gilbertocarcano/Progetto-ACME/Docs/Presentazione/Presentazione-ACME-Redesign.pdf

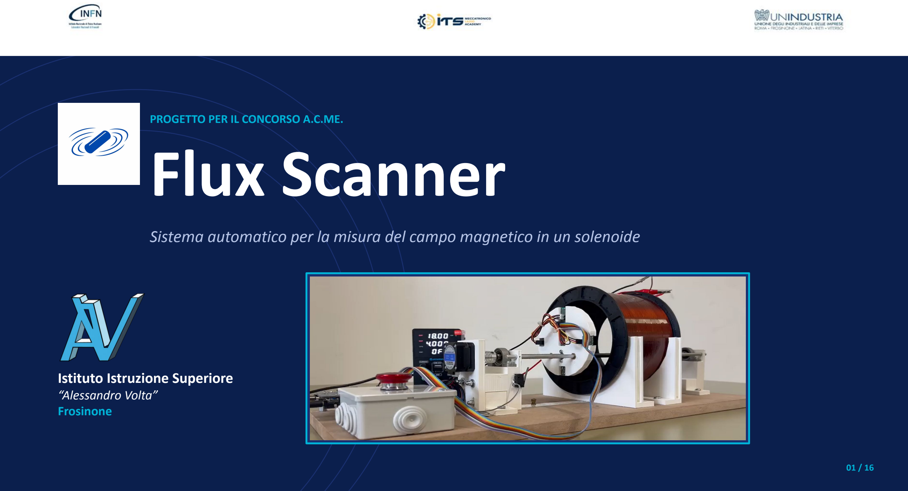
[picture p1: figure]
PROGETTO PER IL CONCORSO A.C.ME. Flux Scanner; Istituto Istruzione Superiore “Alessandro Volta” Frosinone

## Sistema automatico per la misura del campo magnetico in un solenoide

# Il problema fisico

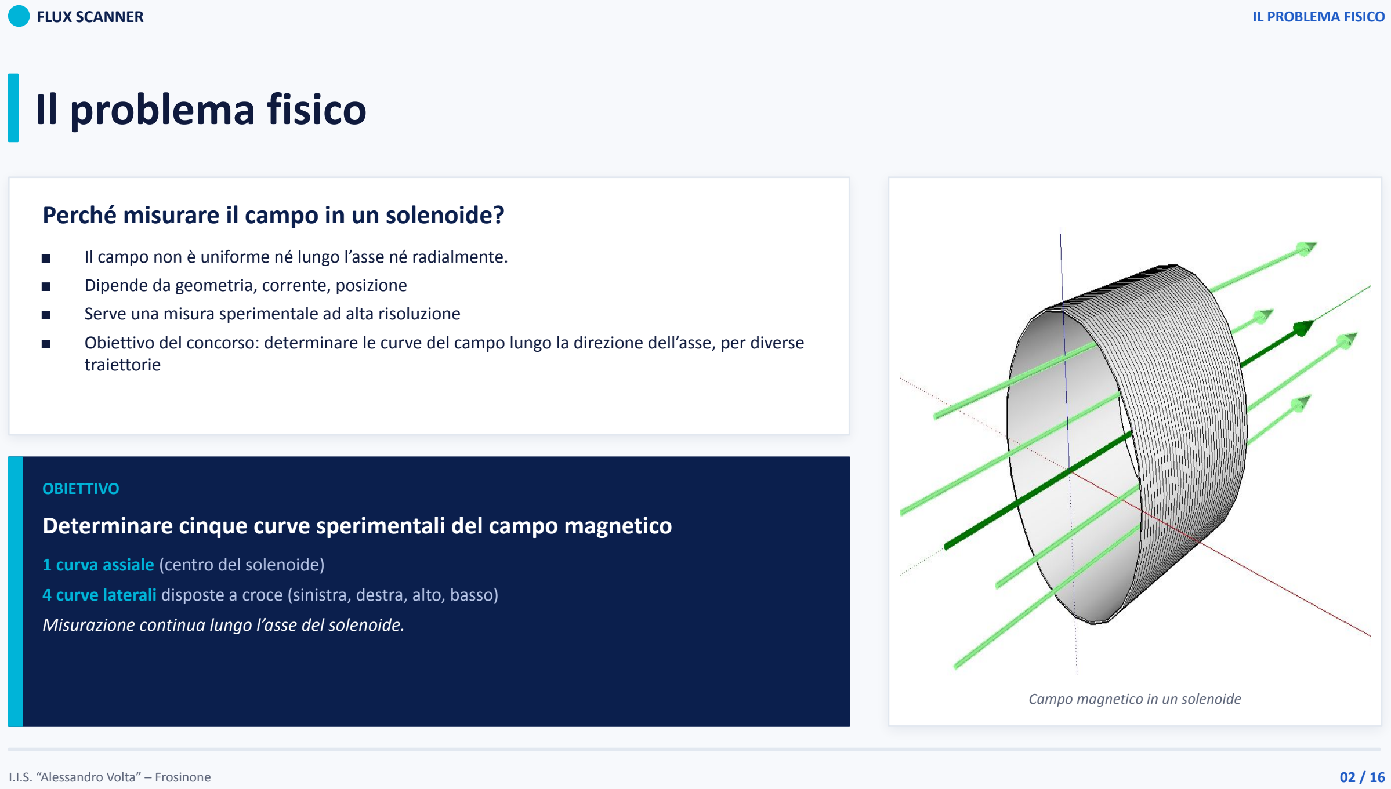
[picture p2: page 2]

FLUX SCANNER | IL PROBLEMA FISICO
I.I.S. “Alessandro Volta” – Frosinone | 02 / 16

## Perché misurare il campo in un solenoide?

■ | Il campo non è uniforme né lungo l’asse né radialmente.
■ | Dipende da geometria, corrente, posizione
■ | Serve una misura sperimentale ad alta risoluzione
■ | Obiettivo del concorso: determinare le curve del campo lungo la direzione dell’asse, per diverse traiettorie

OBIETTIVO

## Determinare cinque curve sperimentali del campo magnetico

### 1 curva assiale (centro del solenoide)

### 4 curve laterali disposte a croce (sinistra, destra, alto, basso)

Misurazione continua lungo l’asse del solenoide.

Campo magnetico in un solenoide

# Obiettivo del progetto

## Realizzare un sistema automatico in grado di:

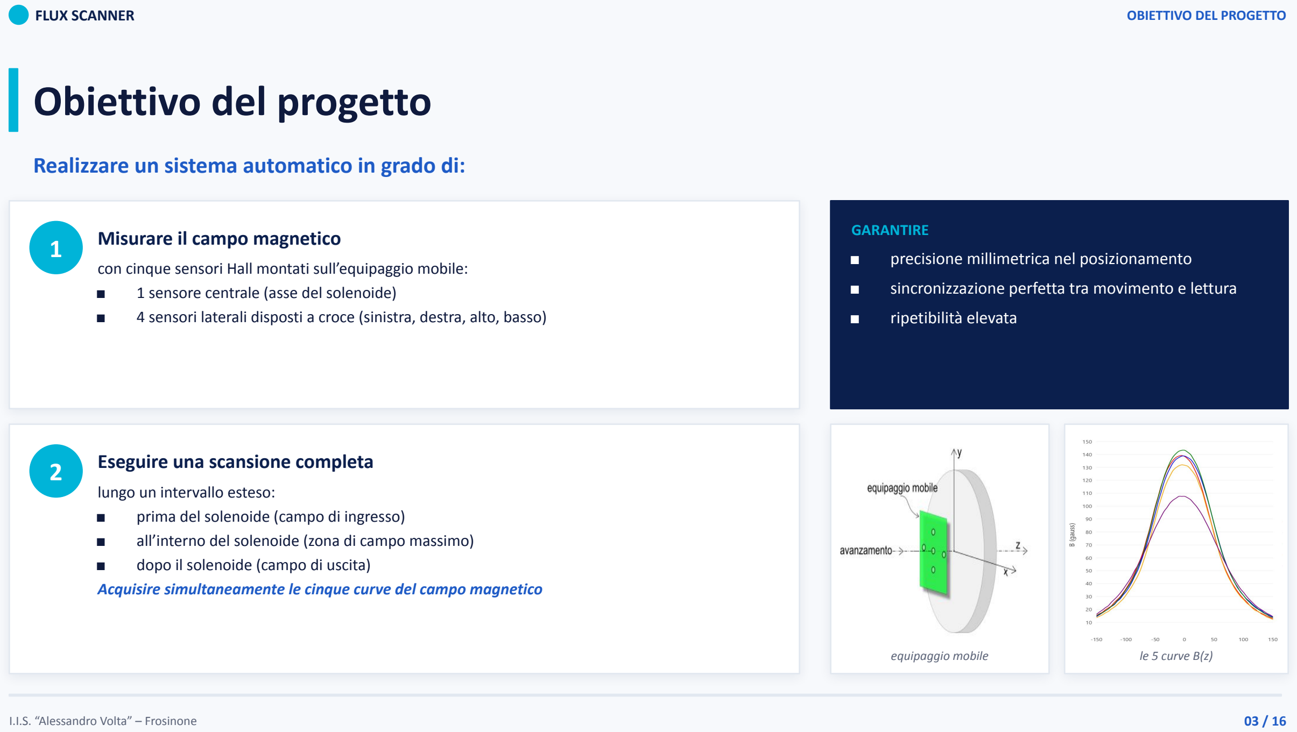
[picture p3: page 3]

FLUX SCANNER | OBIETTIVO DEL PROGETTO

1

### Misurare il campo magnetico

con cinque sensori Hall montati sull’equipaggio mobile:
■ | 1 sensore centrale (asse del solenoide)
■ | 4 sensori laterali disposti a croce (sinistra, destra, alto, basso)

2

### Eseguire una scansione completa

lungo un intervallo esteso:
■ | prima del solenoide (campo di ingresso)
■ | all’interno del solenoide (zona di campo massimo)
■ | dopo il solenoide (campo di uscita)
Acquisire simultaneamente le cinque curve del campo magnetico

GARANTIRE
■ | precisione millimetrica nel posizionamento
■ | sincronizzazione perfetta tra movimento e lettura
■ | ripetibilità elevata
equipaggio mobile | le 5 curve B(z)

# Architettura generale del sistema

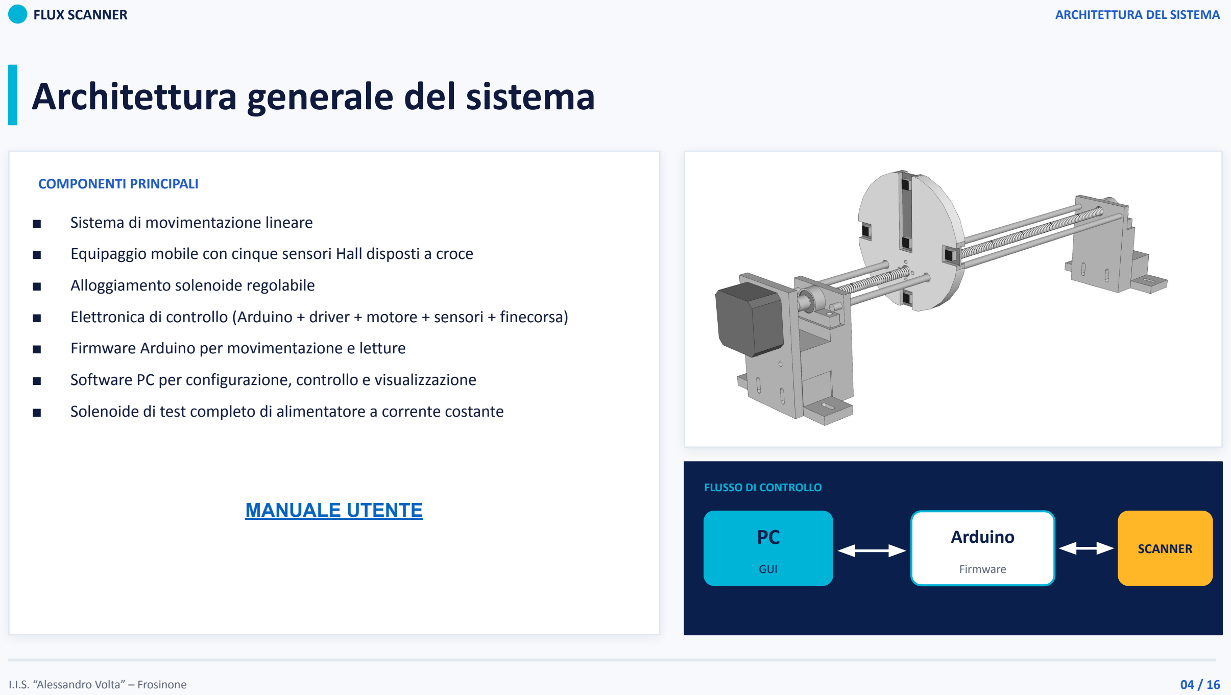
[picture p4: page 4]

FLUX SCANNER | ARCHITETTURA DEL SISTEMA

COMPONENTI PRINCIPALI

■ | Sistema di movimentazione lineare
■ | Equipaggio mobile con cinque sensori Hall disposti a croce
■ | Alloggiamento solenoide regolabile
■ | Elettronica di controllo (Arduino + driver + motore + sensori + finecorsa)
■ | Firmware Arduino per movimentazione e letture
■ | Software PC per configurazione, controllo e visualizzazione
■ | Solenoide di test completo di alimentatore a corrente costante

PC

GUI

### Arduino

Firmware

SCANNER

FLUSSO DI CONTROLLO
MANUALE UTENTE (https://drive.google.com/file/d/1rOk_jEiZlnx1uidPcFdmK0FjRhwg7ija/view?usp=drive_link)

# Scelte meccaniche: movimentazione

## Movimentazione lineare ad alta precisione

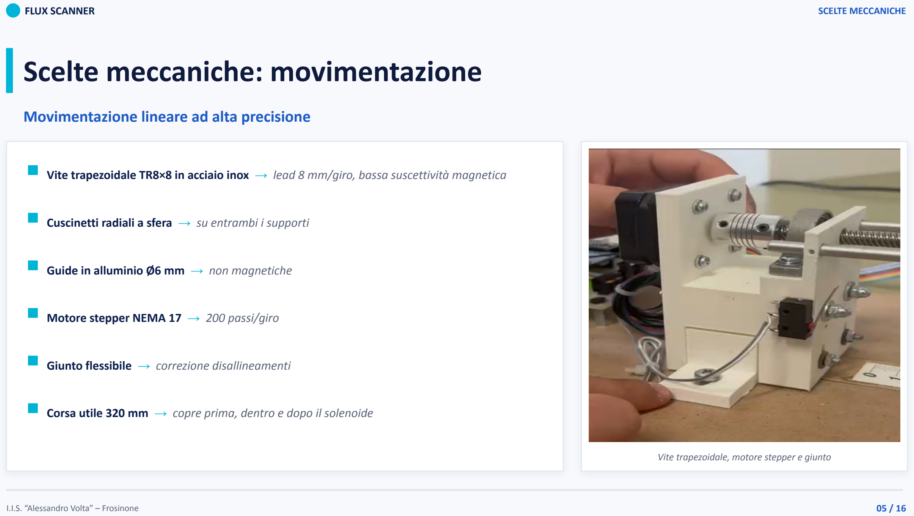
[picture p5: page 5]

FLUX SCANNER | SCELTE MECCANICHE

Vite trapezoidale TR8×8 in acciaio inox → lead 8 mm/giro, bassa suscettività magnetica

Cuscinetti radiali a sfera → su entrambi i supporti

Guide in alluminio Ø6 mm → non magnetiche

Motore stepper NEMA 17 → 200 passi/giro

Giunto flessibile → correzione disallineamenti

Corsa utile 320 mm → copre prima, dentro e dopo il solenoide

Vite trapezoidale, motore stepper e giunto

# Scelte meccaniche: equipaggio mobile

## Equipaggio mobile con 5 sensori

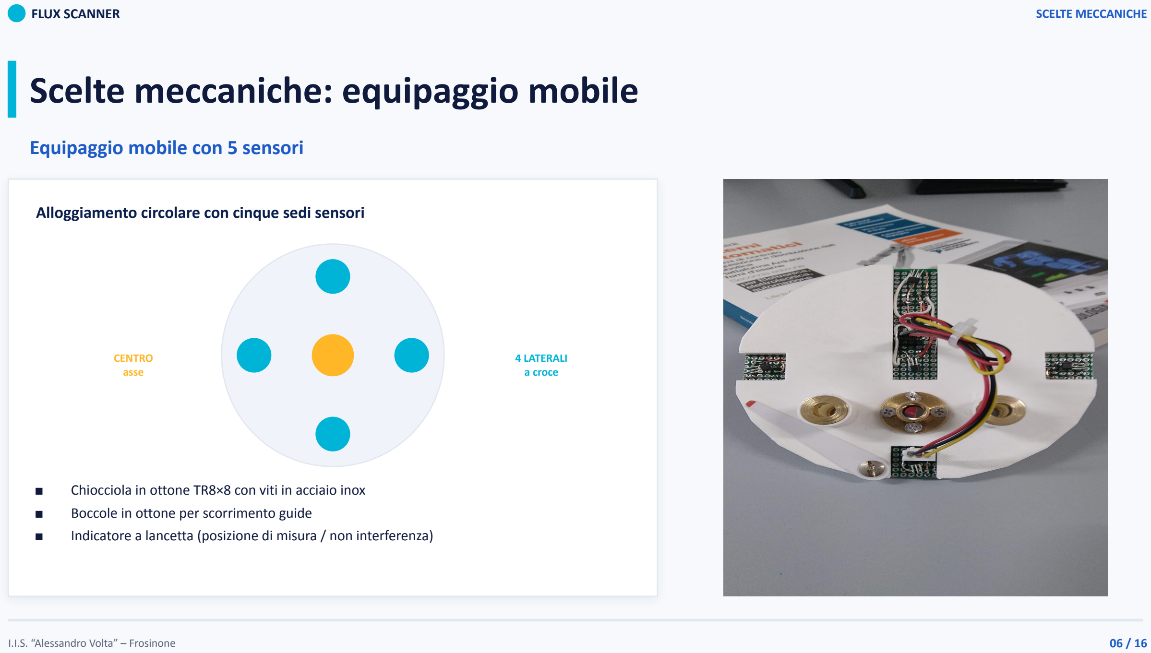
[picture p6: page 6]

FLUX SCANNER | SCELTE MECCANICHE

Alloggiamento circolare con cinque sedi sensori

CENTRO
asse

### 4 LATERALI

a croce

■ | Chiocciola in ottone TR8×8 con viti in acciaio inox
■ | Boccole in ottone per scorrimento guide
■ | Indicatore a lancetta (posizione di misura / non interferenza)

Carrello con disposizione “a croce” dei sensori

# Alloggiamento solenoide e calibrazione

## Allineamento e ripetibilità

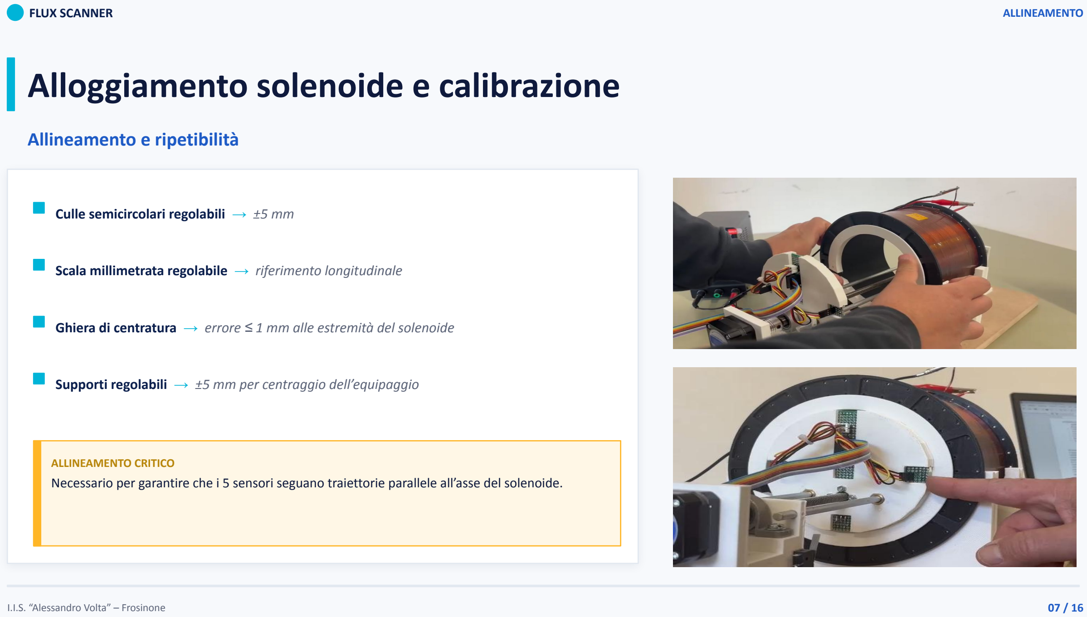
[picture p7: page 7]

FLUX SCANNER | ALLINEAMENTO

Culle semicircolari regolabili → ±5 mm

Scala millimetrata regolabile → riferimento longitudinale

Ghiera di centratura → errore ≤ 1 mm alle estremità del solenoide

Supporti regolabili → ±5 mm per centraggio dell’equipaggio

ALLINEAMENTO CRITICO
Necessario per garantire che i 5 sensori seguano traiettorie parallele all’asse del solenoide.

# Scelte elettroniche

## Elettronica di controllo

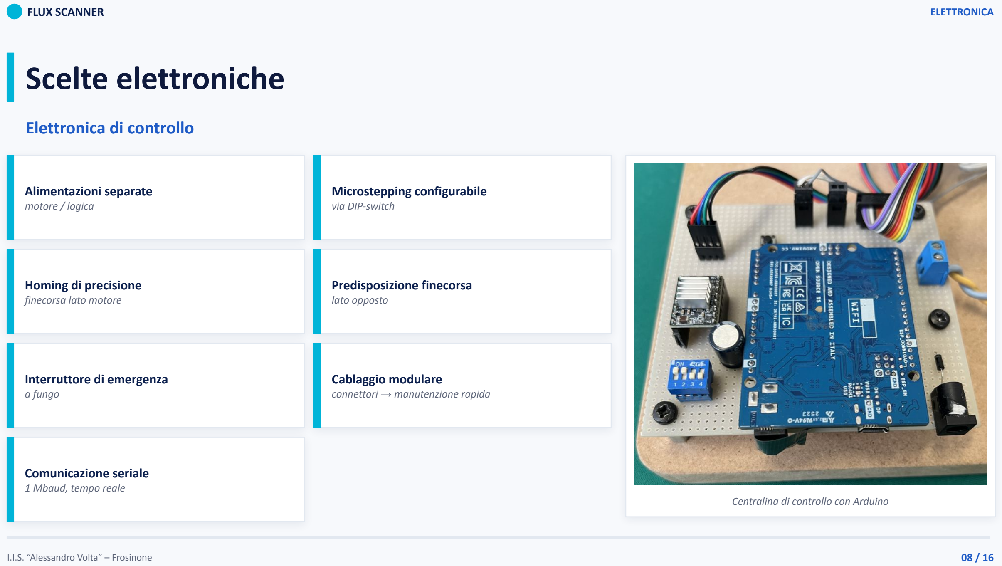
[picture p8: page 8]

FLUX SCANNER | ELETTRONICA

Alimentazioni separate
motore / logica

Microstepping configurabile
via DIP-switch

Homing di precisione
finecorsa lato motore

Predisposizione finecorsa
lato opposto

Interruttore di emergenza
a fungo

Cablaggio modulare
connettori → manutenzione rapida

Comunicazione seriale
1 Mbaud, tempo reale
Centralina di controllo con Arduino

# Firmware Arduino

## Caratteristiche del firmware

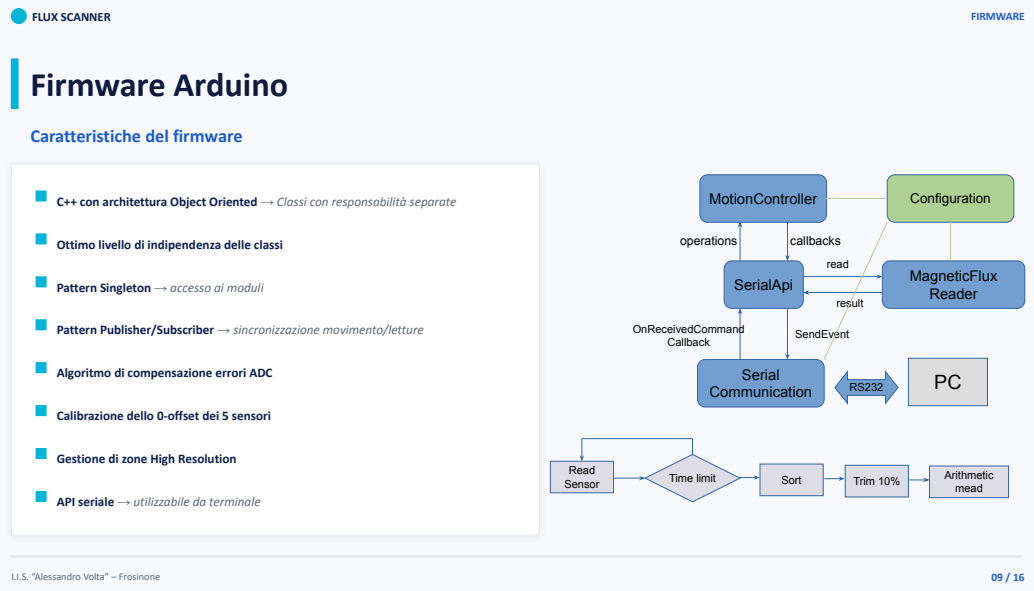
[picture p9: page 9]
FLUX SCANNER; FIRMWARE; MotionController; SerialApi; Serial Communication; MagneticFlux Reader; read; result; operations; SendEvent; Configuration; callbacks; OnReceivedCommand Callback; Read; Sensor; Time limit; Sort; Trim 10%; Arithmetic; mead

C++ con architettura Object Oriented → Classi con responsabilità separate

Ottimo livello di indipendenza delle classi

Pattern Singleton → accesso ai moduli

Pattern Publisher/Subscriber → sincronizzazione movimento/letture

Algoritmo di compensazione errori ADC

Calibrazione dello 0-offset dei 5 sensori

Gestione di zone High Resolution

API seriale → utilizzabile da terminale

# Efficacia dell’algoritmo di compensazione errori ADC

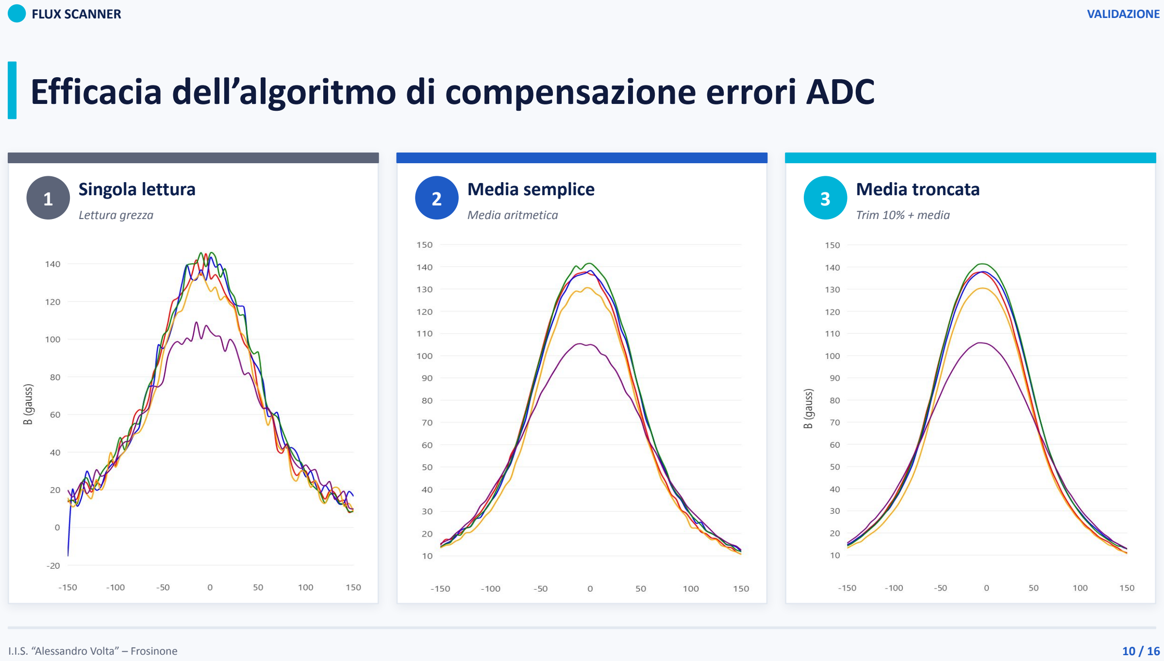
[picture p10: page 10]

FLUX SCANNER | VALIDAZIONE

1

### Singola lettura

Lettura grezza

### 2 Media semplice

Media aritmetica

### 3 Media troncata

Trim 10% + media

# Interfaccia utente Flux Scanner (PC)

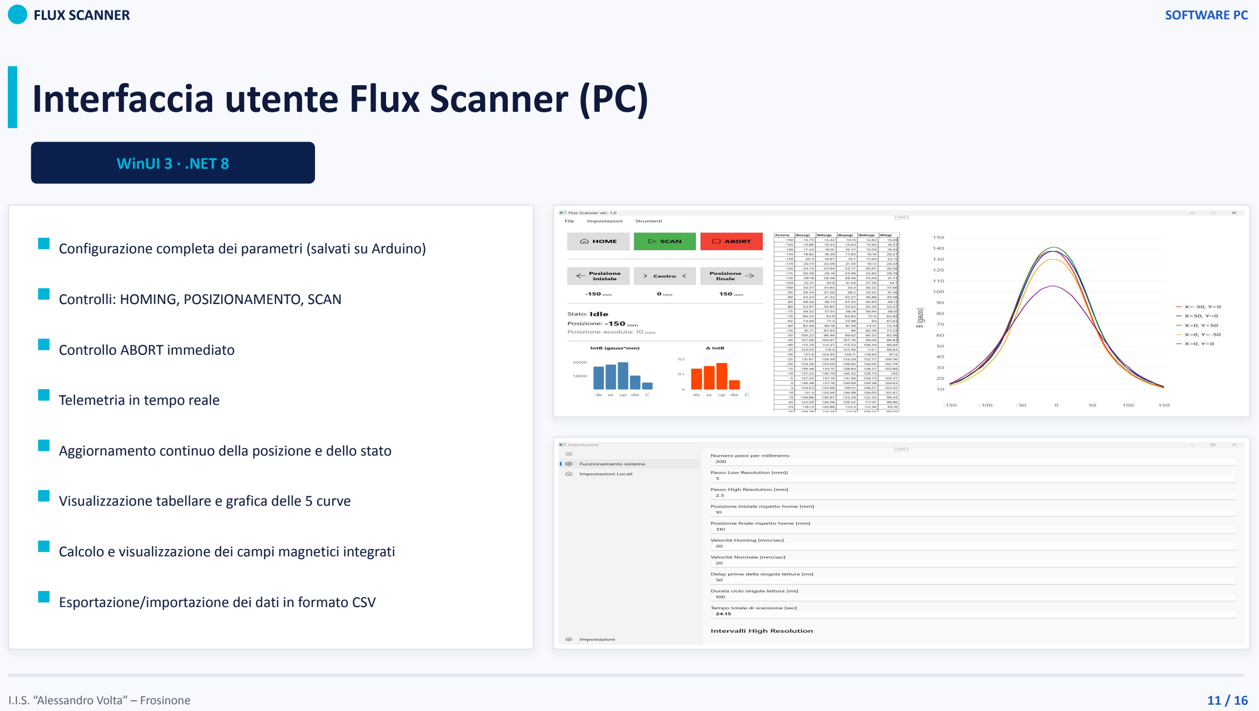
[picture p11: page 11]

FLUX SCANNER | SOFTWARE PC

WinUI 3 · .NET 8

Configurazione completa dei parametri (salvati su Arduino)

Controlli: HOMING, POSIZIONAMENTO, SCAN

Controllo ABORT immediato

Telemetria in tempo reale

Aggiornamento continuo della posizione e dello stato

Visualizzazione tabellare e grafica delle 5 curve

Calcolo e visualizzazione dei campi magnetici integrati

Esportazione/importazione dei dati in formato CSV

# Funzionamento del sistema

## Sequenza operativa

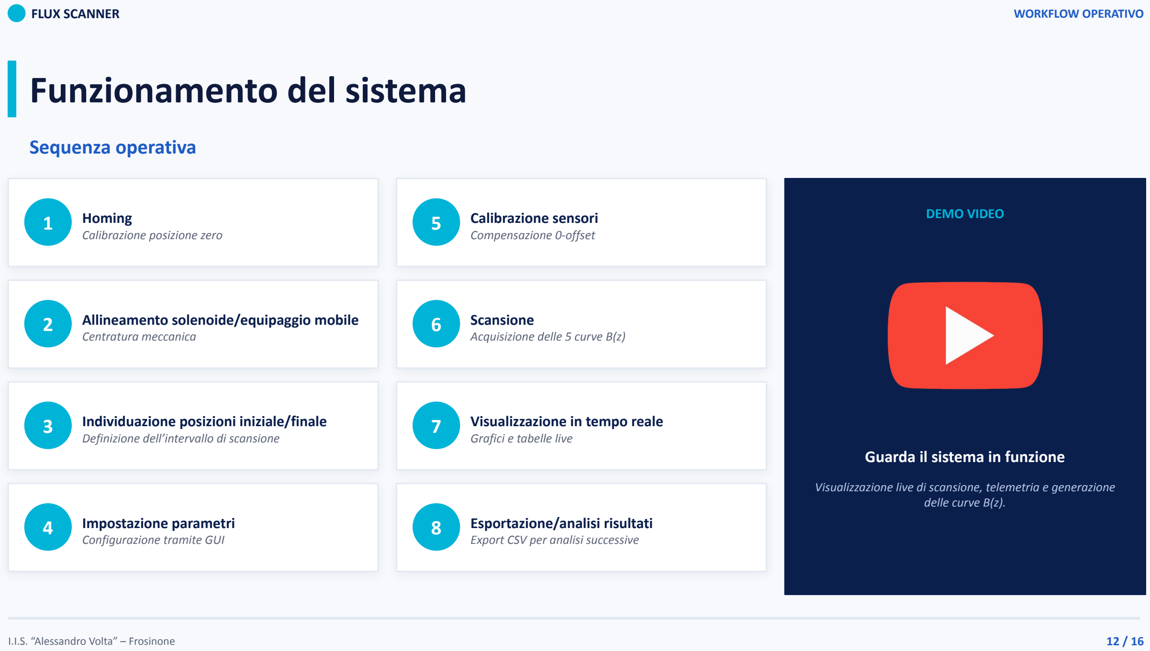
[picture p12: page 12]

FLUX SCANNER | WORKFLOW OPERATIVO

1

Homing
Calibrazione posizione zero

2

Allineamento solenoide/equipaggio mobile
Centratura meccanica

3

Individuazione posizioni iniziale/finale
Definizione dell’intervallo di scansione

4

Impostazione parametri
Configurazione tramite GUI

5

Calibrazione sensori
Compensazione 0-offset

6

Scansione
Acquisizione delle 5 curve B(z)

7

Visualizzazione in tempo reale
Grafici e tabelle live

8

Esportazione/analisi risultati
Export CSV per analisi successive

DEMO VIDEO

Guarda il sistema in funzione

Visualizzazione live di scansione, telemetria e generazione delle curve B(z).

# Risultati sperimentali

## Risultati ottenuti

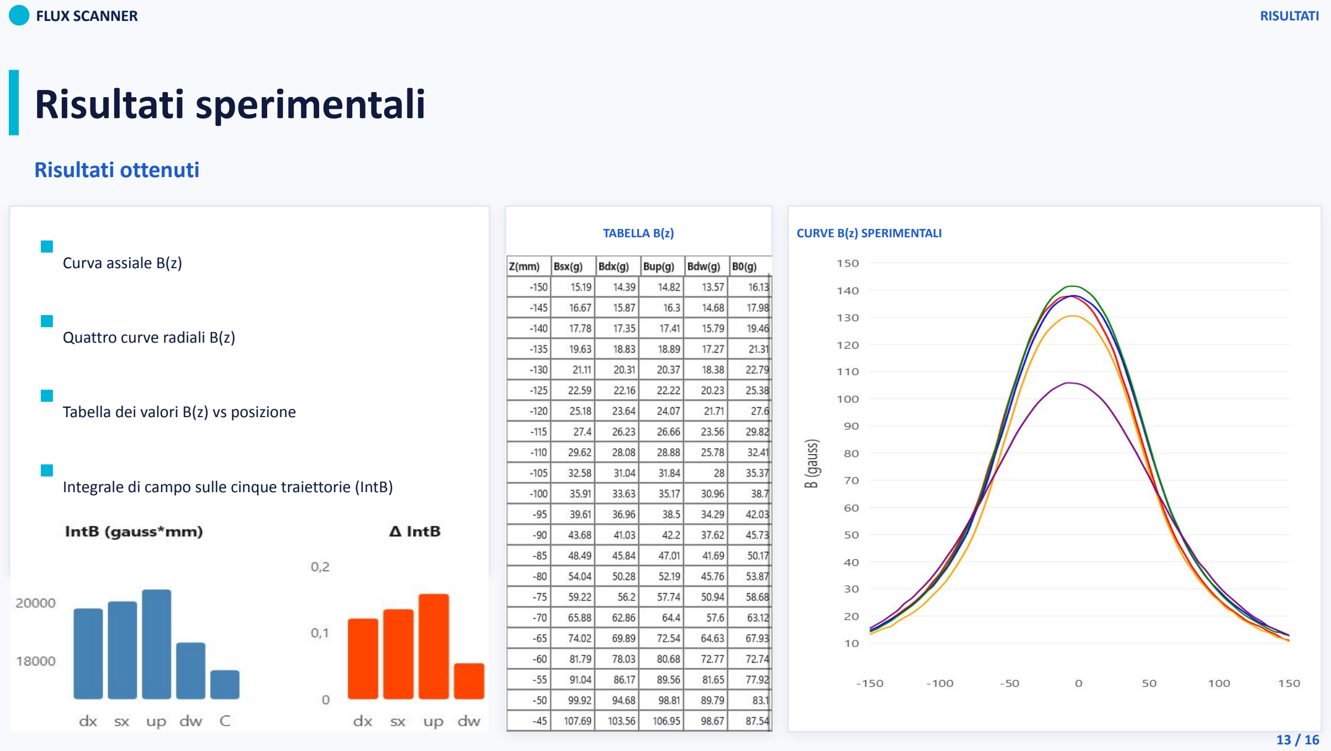
[picture p13: page 13]

FLUX SCANNER | RISULTATI

13 / 16

Curva assiale B(z)

Quattro curve radiali B(z)

Tabella dei valori B(z) vs posizione

Integrale di campo sulle cinque traiettorie (IntB)

Variazione integrali di campo laterali vs centrale (ΔIntB)

TABELLA B(z) | CURVE B(z) SPERIMENTALI

# Punti di forza del progetto

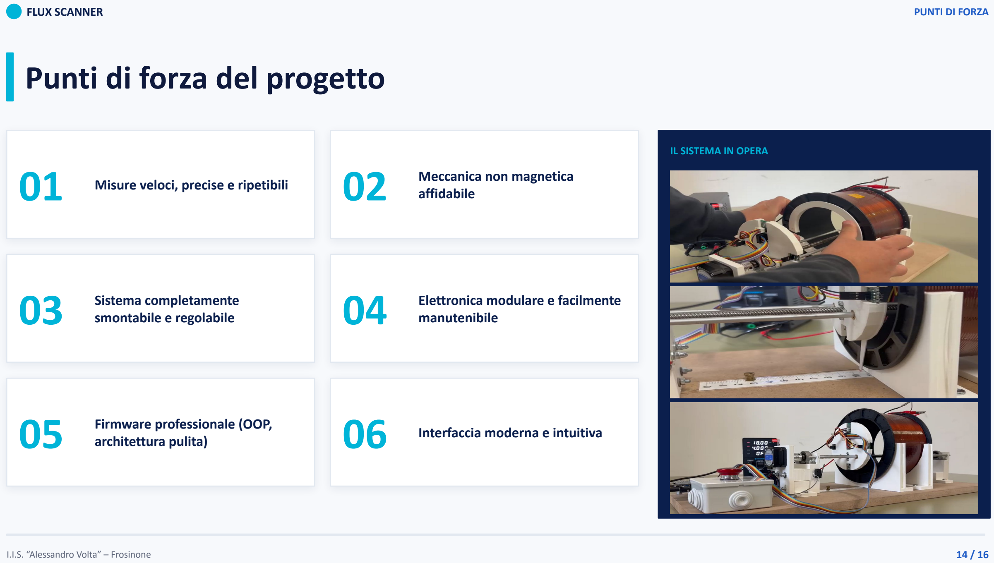
[picture p14: page 14]

FLUX SCANNER | PUNTI DI FORZA
01 | Misure veloci, precise e ripetibili | 02 | Meccanica non magnetica affidabile

### 03 Sistema completamente

smontabile e regolabile | 04 | Elettronica modulare e facilmente manutenibile

05 Firmware professionale (OOP,

architettura pulita) | 06 | Interfaccia moderna e intuitiva

IL SISTEMA IN OPERA

# Conclusioni

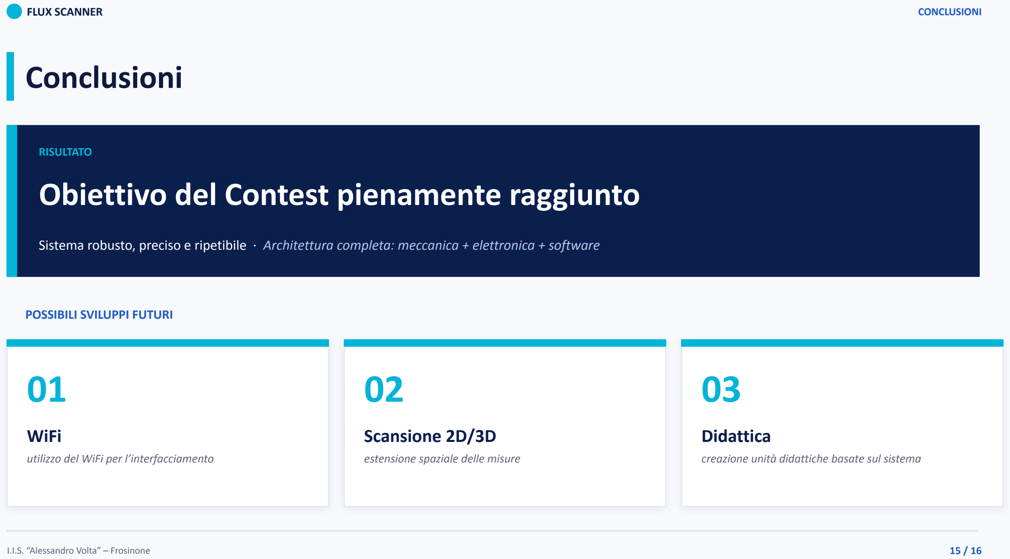
[picture p15: page 15]

FLUX SCANNER | CONCLUSIONI

RISULTATO

# Obiettivo del Contest pienamente raggiunto

Sistema robusto, preciso e ripetibile · Architettura completa: meccanica + elettronica + software

POSSIBILI SVILUPPI FUTURI
01

## WiFi

utilizzo del WiFi per l’interfacciamento

02

## Scansione 2D/3D

estensione spaziale delle misure

03

## Didattica

creazione unità didattiche basate sul sistema

GRAZIE.

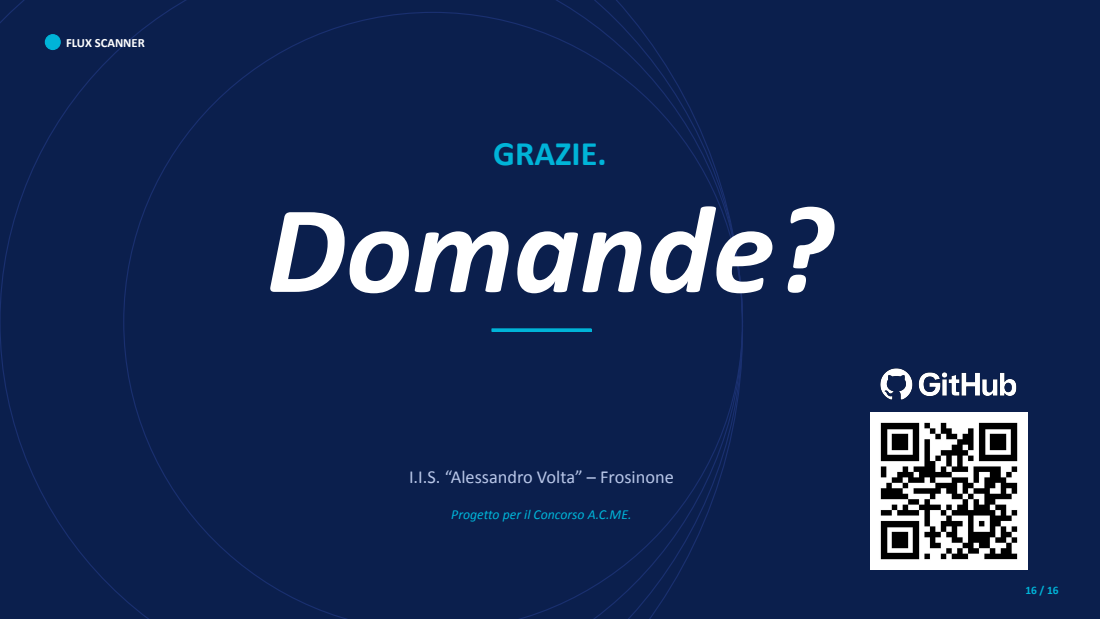
[picture p16: page 16]
FLUX SCANNER; Domande?

I.I.S. “Alessandro Volta” – Frosinone

Progetto per il Concorso A.C.ME.
