gilbertocarcano/Progetto-ACME/Docs/Indice documentazione.pdf

### INDICE DOCUMENTAZIONE PRODOTTA

Cartella ./DOCS/Manuale Utente
Contiene il Manuale Utente in formato PDF

Cartella ./DOCS/Tavole meccanica
Contiene gli elaborati grafici delle parti meccaniche componenti in formato PDF

Cartella ./DOCS/Schema elettrico
Contiene lo schema elettrico della scheda elettronica in formato PDF

Cartella ./DOCS/3D
Contiene i progetti 3D degli elementi stampabili nei formati .skp, .dae e .step

Cartella ./DOCS/Presentazione
Contiene la Presentazione nei formati PDF e .pptx

Cartella ./DOCS/Video
Contiene il videoclip dimostrativo in formato .mp4
