gilbertocarcano/Progetto-ACME/Docs/3D/step/EquipaggioMobile.step

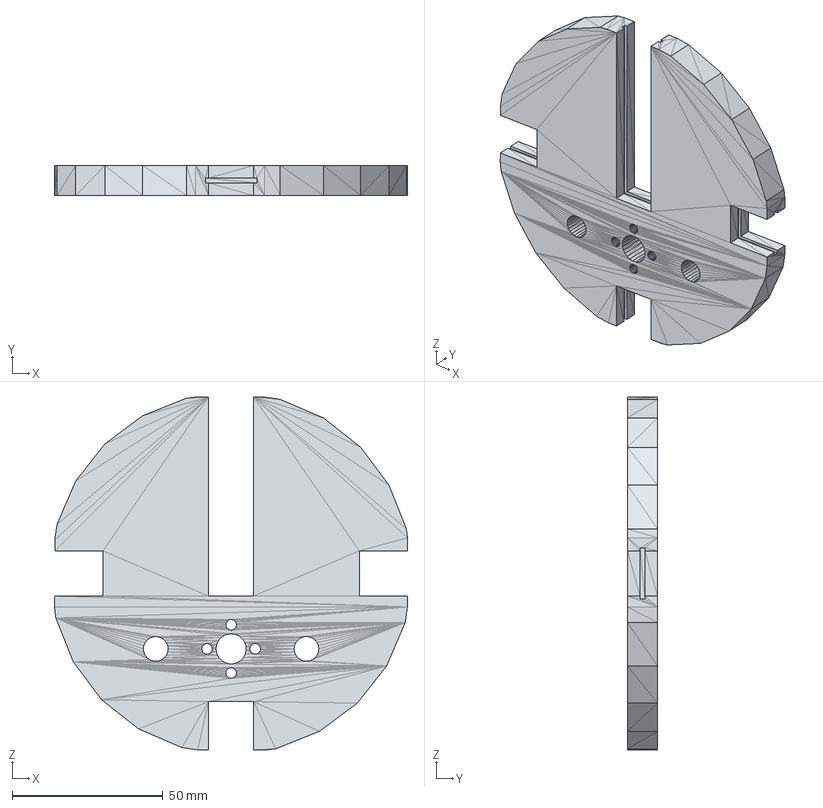
[picture p17: CAD file, 2026-05-17]
Docs/3D/step/EquipaggioMobile.step
117.1 x 10.0 x 117.0 mm
ID001 (Solid)
ID002 (Solid)
ID003 (Solid)
ID004 (Solid)
ID005 (Solid)
ID006 (Solid)
ID007 (Solid)
ID008 (Solid)
