gilbertocarcano/Progetto-ACME/Docs/3D/step/SupportoBobina.step

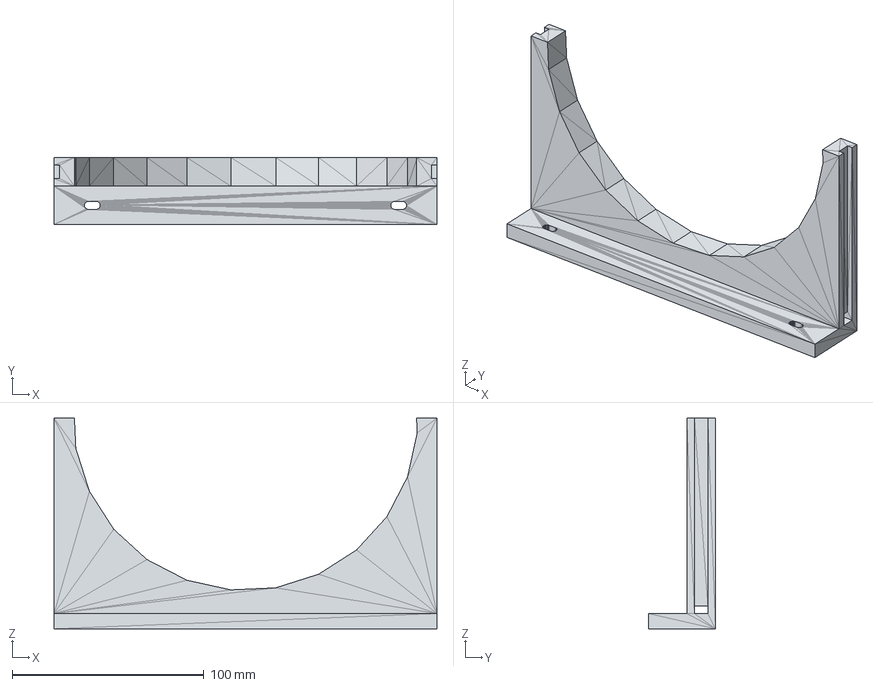
[picture p18: CAD file, 2026-05-17]
Docs/3D/step/SupportoBobina.step
200.0 x 35.0 x 110.0 mm
ID001 (Solid)
ID002 (Solid)
ID003 (Solid)
