gilbertocarcano/Progetto-ACME/Docs/3D/step/SupportoThreadedRoad(lato libero).step

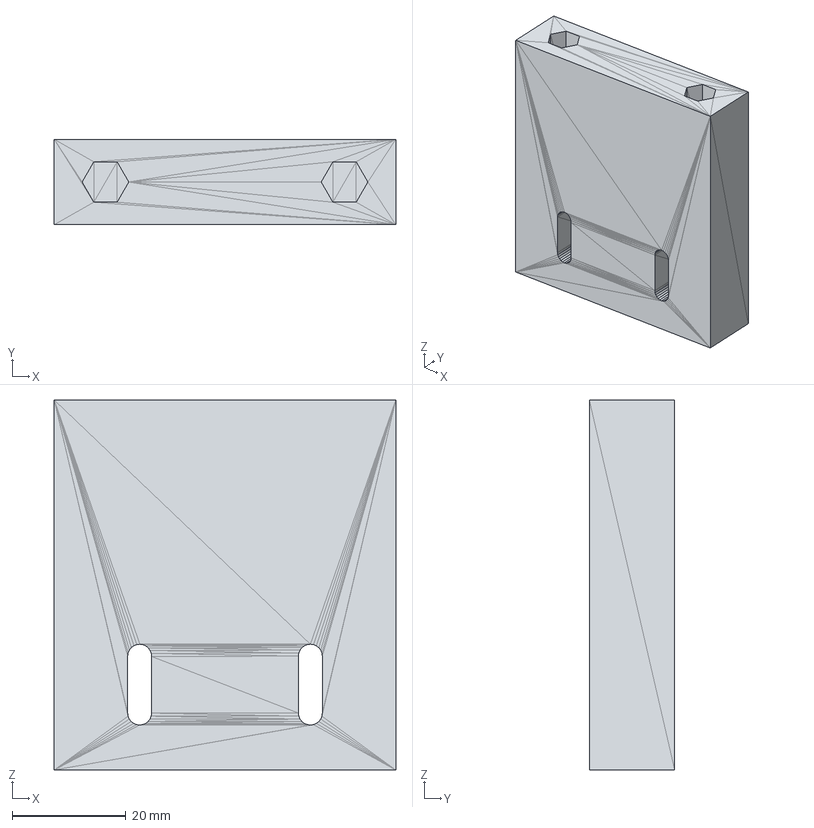
[picture p19: CAD file, 2026-05-17]
Docs/3D/step/SupportoThreadedRoad(lato libero).step
60.0 x 15.0 x 65.0 mm
ID001 (Solid)
ID002 (Solid)
ID003 (Solid)
ID004 (Solid)
ID005 (Solid)
