gilbertocarcano/Progetto-ACME/Docs/3D/step/SupportoMotore.step

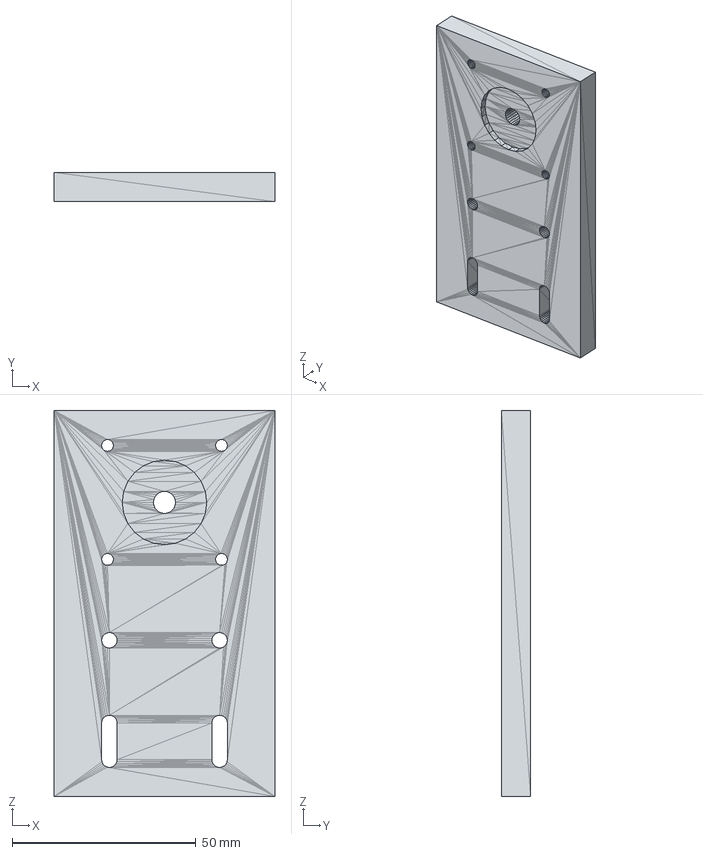
[picture p20: CAD file, 2026-05-17]
Docs/3D/step/SupportoMotore.step
60.0 x 8.00 x 105.0 mm
ID001 (Solid)
ID002 (Solid)
ID003 (Solid)
ID004 (Solid)
ID005 (Solid)
ID006 (Solid)
ID007 (Solid)
ID008 (Solid)
ID009 (Solid)
ID010 (Solid)
ID011 (Solid)
