gilbertocarcano/Progetto-ACME/Docs/3D/step/SupportoThreadedRoad(lato motore).step

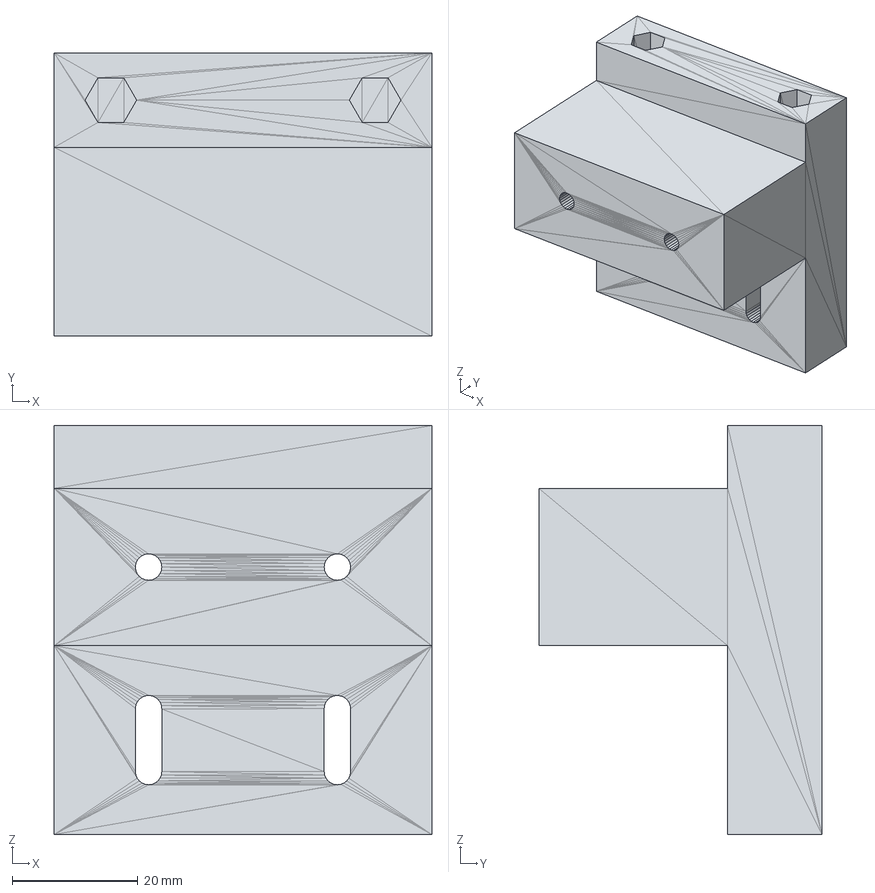
[picture p21: CAD file, 2026-05-17]
Docs/3D/step/SupportoThreadedRoad(lato motore).step
60.0 x 45.0 x 65.0 mm
ID001 (Solid)
ID002 (Solid)
ID003 (Solid)
ID004 (Solid)
ID005 (Solid)
ID006 (Solid)
ID007 (Solid)
