gilbertocarcano/Progetto-ACME/Docs/3D/step/BaseFlangiata.step

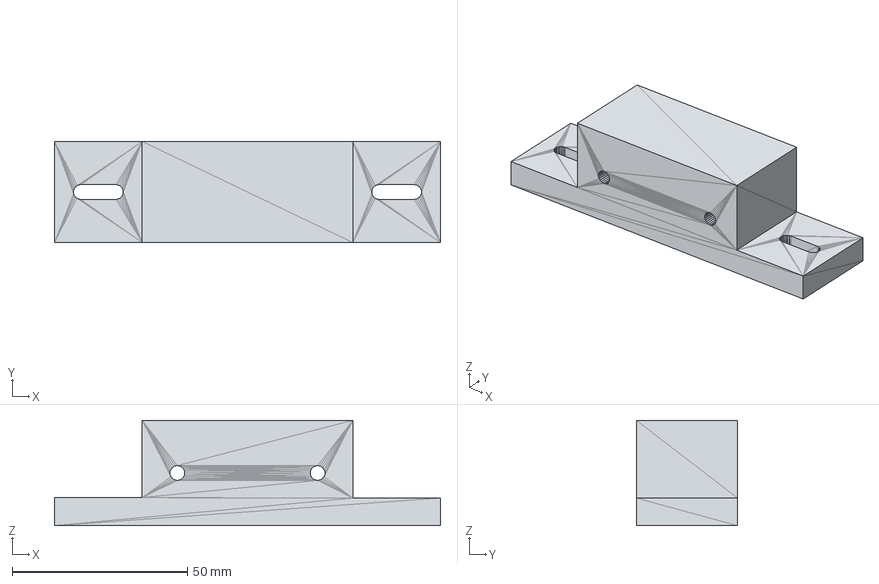
[picture p22: CAD file, 2026-05-17]
Docs/3D/step/BaseFlangiata.step
110.0 x 28.8 x 30.0 mm
ID001 (Solid)
ID002 (Solid)
ID003 (Solid)
ID004 (Solid)
ID005 (Solid)
