gilbertocarcano/Progetto-ACME/(list of files, cad)

Other CAD files:
Docs/3D/sketchup/BaseFlangiata.skp
Docs/3D/sketchup/EquipaggioMobile.skp
Docs/3D/sketchup/SupportoBobina.skp
Docs/3D/sketchup/SupportoMotore.skp
Docs/3D/sketchup/SupportoThreadedRoad(lato libero).skp
Docs/3D/sketchup/SupportoThreadedRoad(lato motore).skp
