gilbertocarcano/Progetto-ACME/Docs/Tavole meccanica/PDF/base flangiata finito.pdf

22 | 29 110 | 60 | 40 10 10 8 | 2225 R 2,1
28 | 35 40 3510 | R 2,1

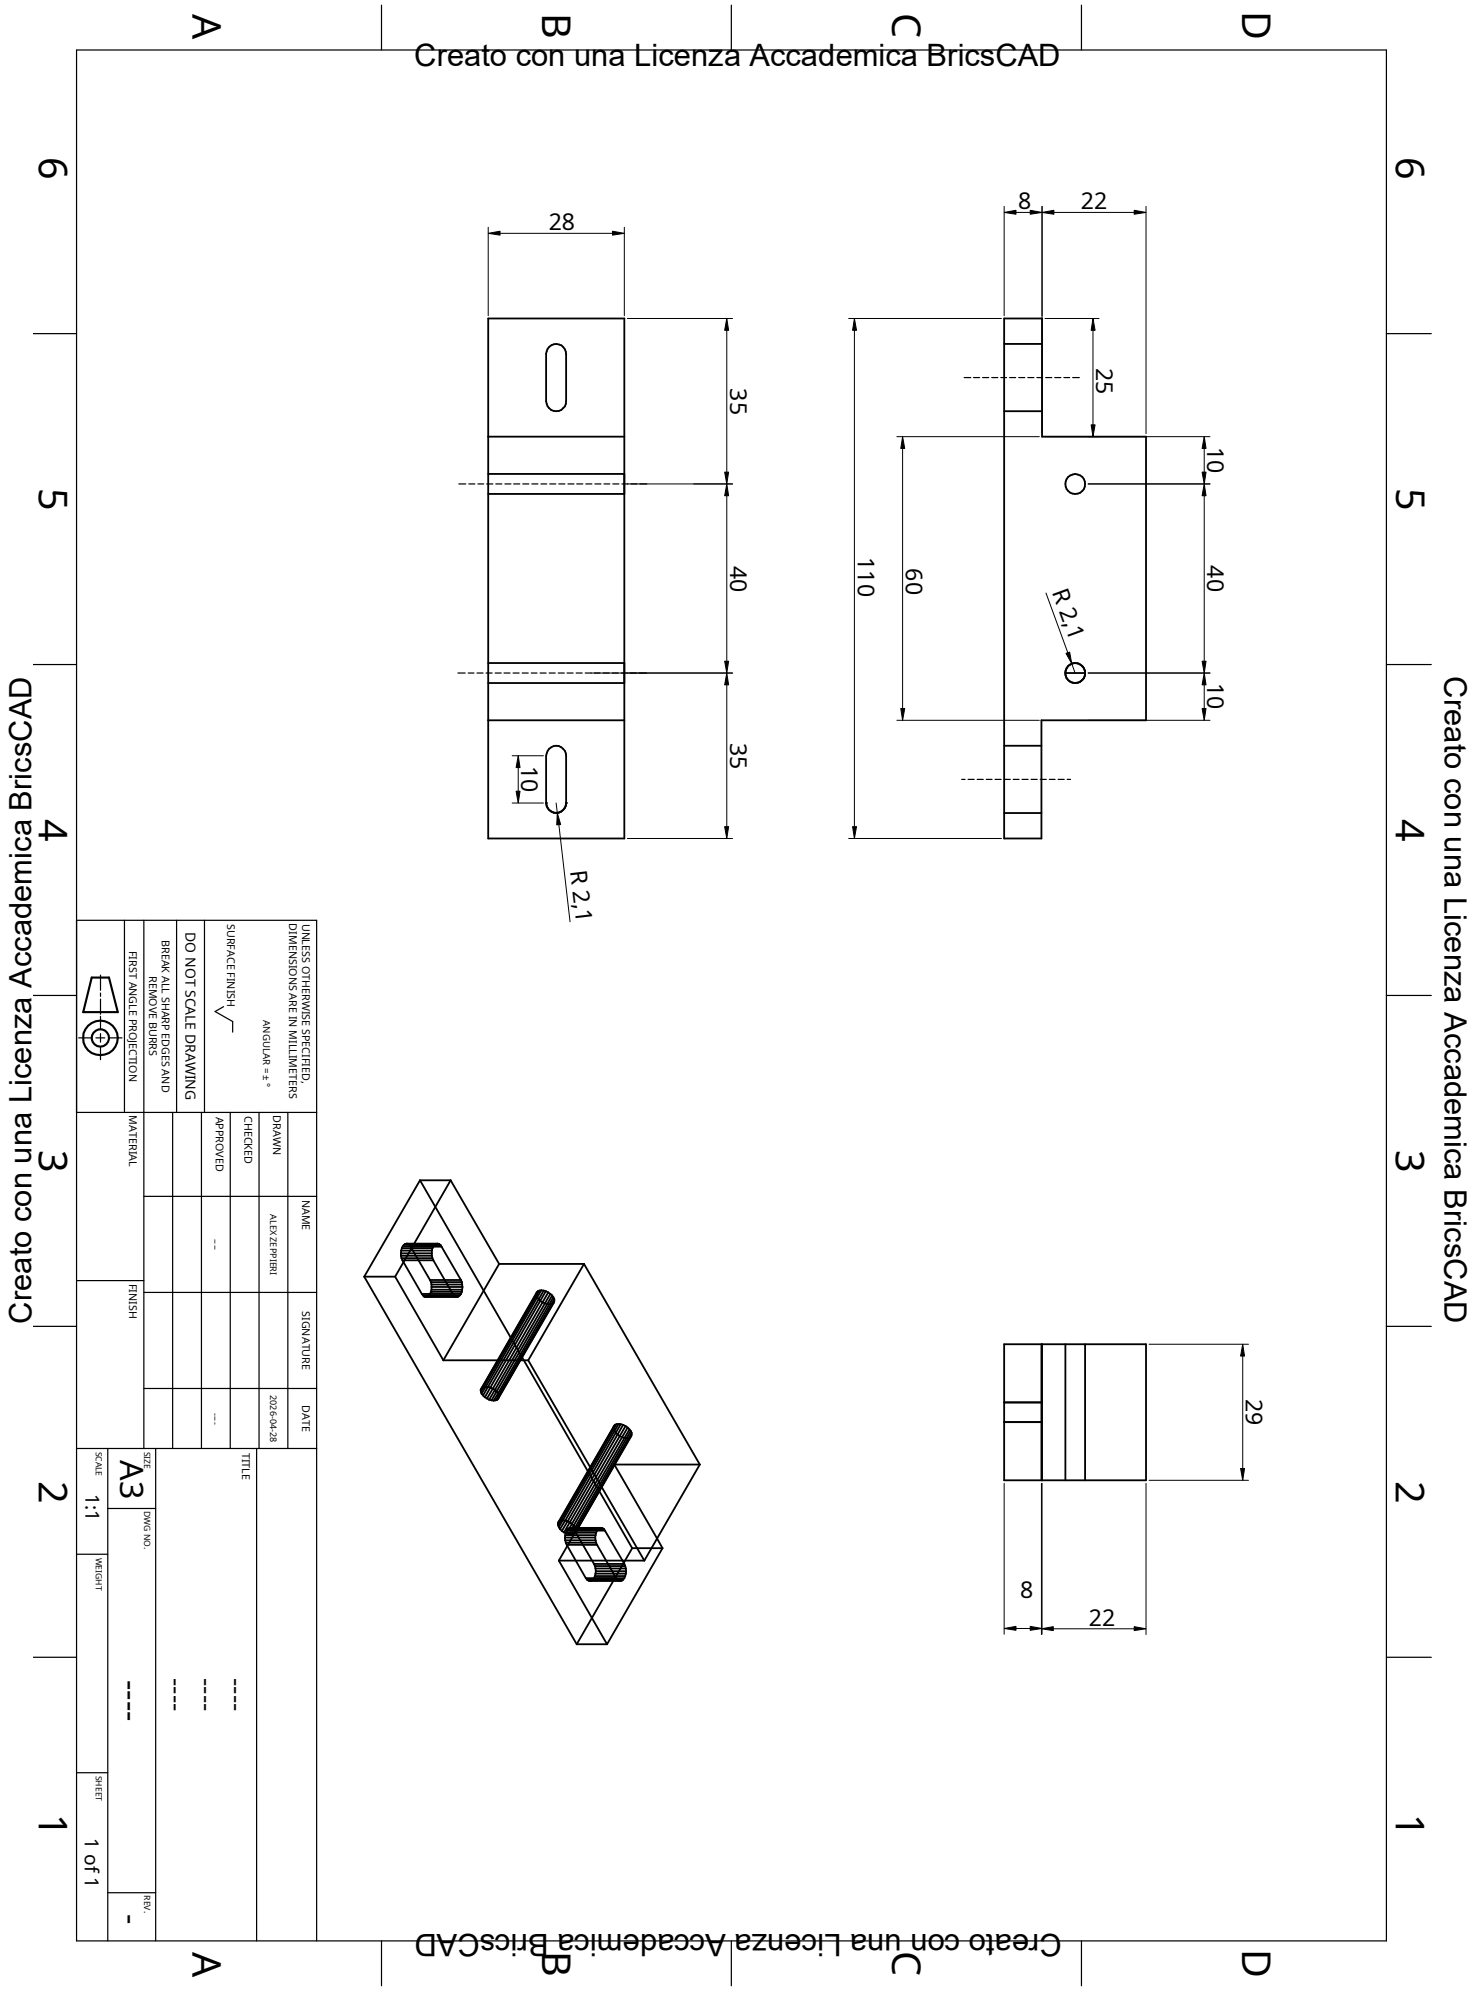
[picture p27: page 1]
Creato con una Licenza Accademica BricsCAD

66 55 44 33 22 11 A A B B C C D D DIMENSIONS ARE IN MILLIMETERS UNLESS OTHERWISE SPECIFIED, ANGULAR = ± ° SURFACE FINISH DO NOT SCALE DRAWING BREAK ALL SHARP EDGES AND REMOVE BURRS FIRST ANGLE PROJECTION SIGNATURE NAME DATE DRAWN ALEX ZEPPIERI 2026-04-28 APPROVED CHECKED ---- ---- MATERIAL FINISH TITLE ---- ---- ---- A3 SIZE DWG NO. ---- REV.- SCALE 1:1 WEIGHT SHEET 1 of 1 8
