gilbertocarcano/Progetto-ACME/Docs/Tavole meccanica/PDF/bobina finita.pdf

Creato con una Licenza Accademica BricsCAD | Creato con una Licenza Accademica BricsCAD

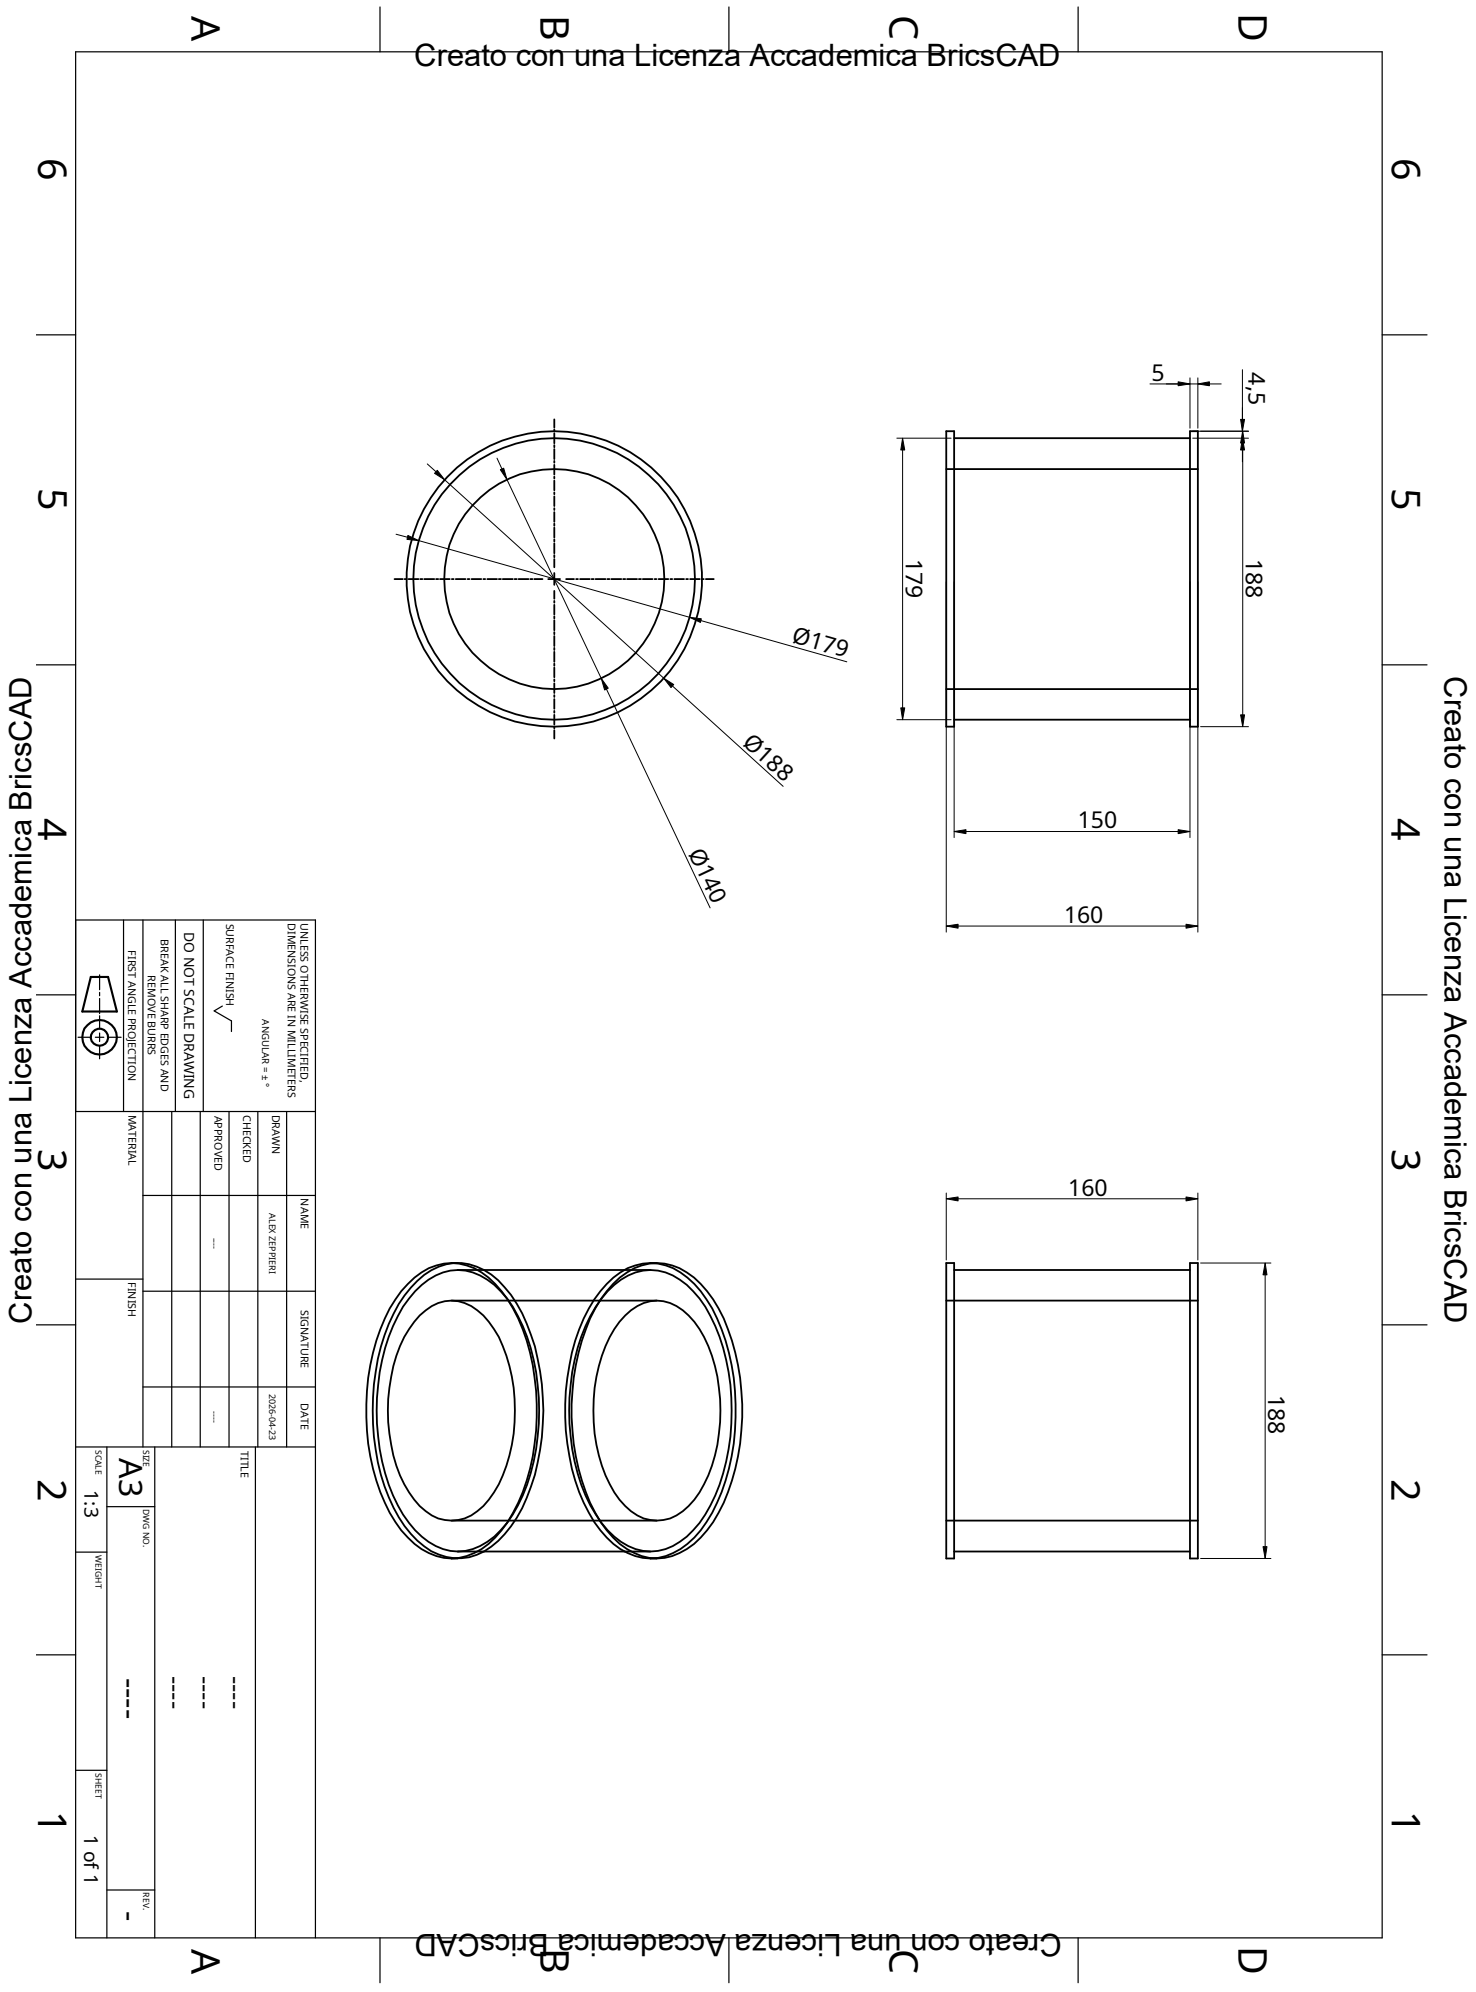
[picture p28: page 1]

66 55 44 33 22 11 A A B B C C D D DIMENSIONS ARE IN MILLIMETERS UNLESS OTHERWISE SPECIFIED, ANGULAR = ± ° SURFACE FINISH DO NOT SCALE DRAWING BREAK ALL SHARP EDGES AND REMOVE BURRS FIRST ANGLE PROJECTION SIGNATURE NAME DATE DRAWN ALEX ZEPPIERI 2026-04-23 APPROVED CHECKED ---- ---- MATERIAL FINISH TITLE ---- ---- ---- A3 SIZE DWG NO. ---- REV.- SCALE 1:3 WEIGHT SHEET 1 of 1 188 5 179 4,5
