gilbertocarcano/Progetto-ACME/Docs/Tavole meccanica/PDF/chiocciola finita.pdf

Creato con una Licenza Accademica BricsCAD | Creato con una Licenza Accademica BricsCAD

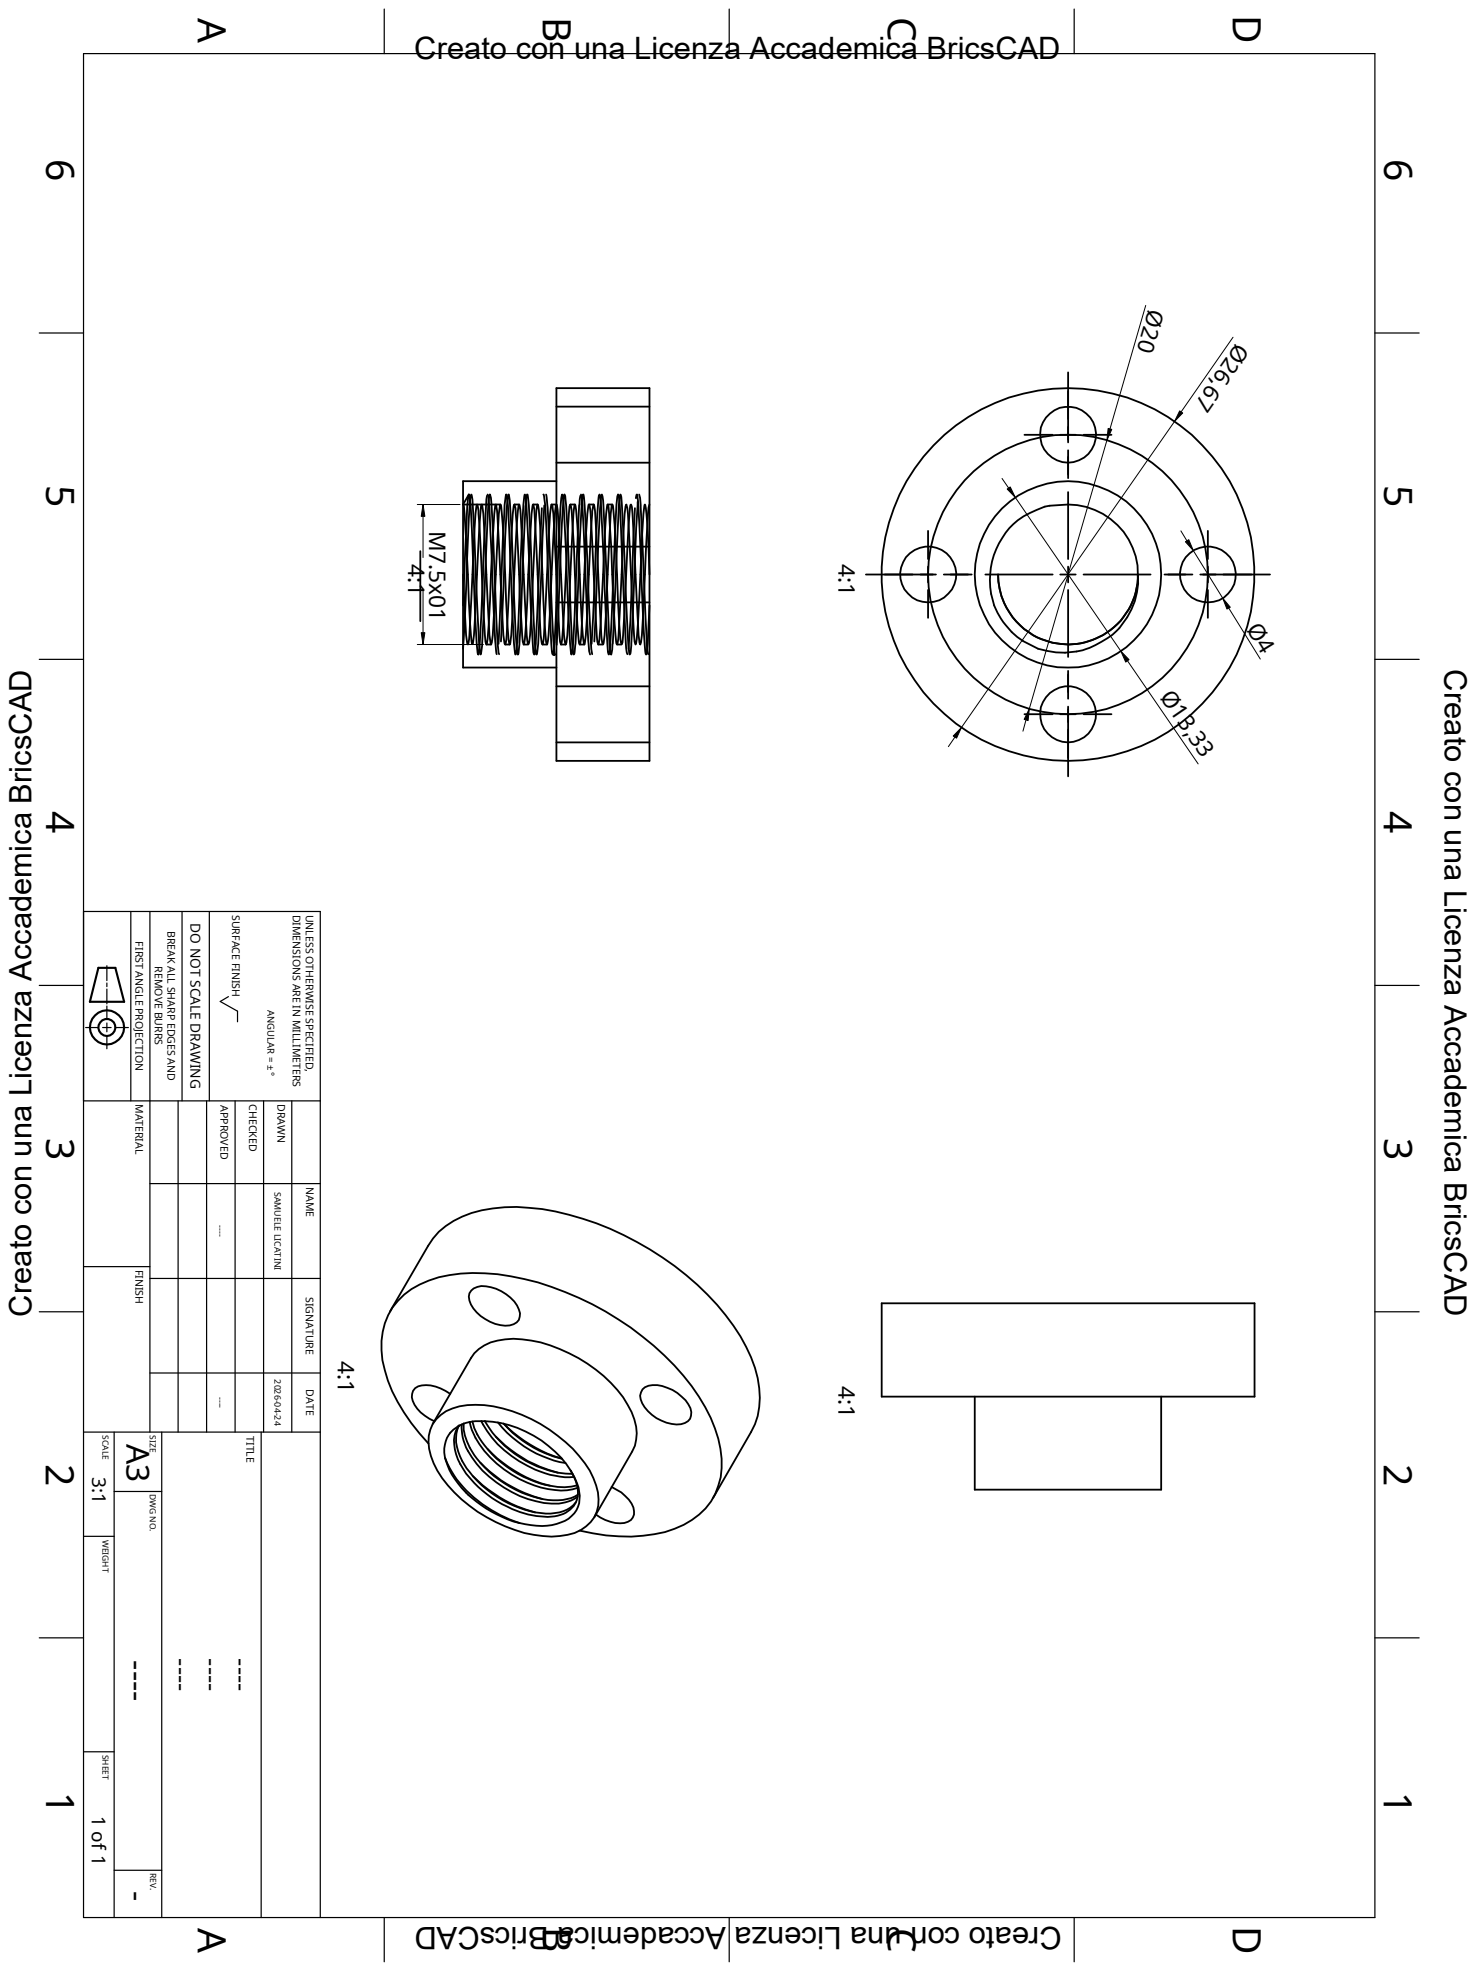
[picture p29: page 1]

66 55 44 33 22 11 A A B B C C D D DIMENSIONS ARE IN MILLIMETERS UNLESS OTHERWISE SPECIFIED, ANGULAR = ± ° SURFACE FINISH DO NOT SCALE DRAWING BREAK ALL SHARP EDGES AND REMOVE BURRS FIRST ANGLE PROJECTION SIGNATURE NAME DATE DRAWN SAMUELE LICATINI 2026-04-24 APPROVED CHECKED ---- ---- MATERIAL FINISH TITLE ---- ---- ---- A3 SIZE DWG NO. ---- REV.- SCALE 3:1 WEIGHT SHEET 1 of 1 4:1 4:1 Ø4Ø13,3 Ø26 6, 7 Ø20 M7.5x01 4:1 4:1
