gilbertocarcano/Progetto-ACME/Docs/Tavole meccanica/PDF/cuscinetto 2 finito.pdf

13 55 | 108 | Ø5 ¹³,5 13,5 28 | 13
29 ⁴² ⁶,5 7 6,5 = | =

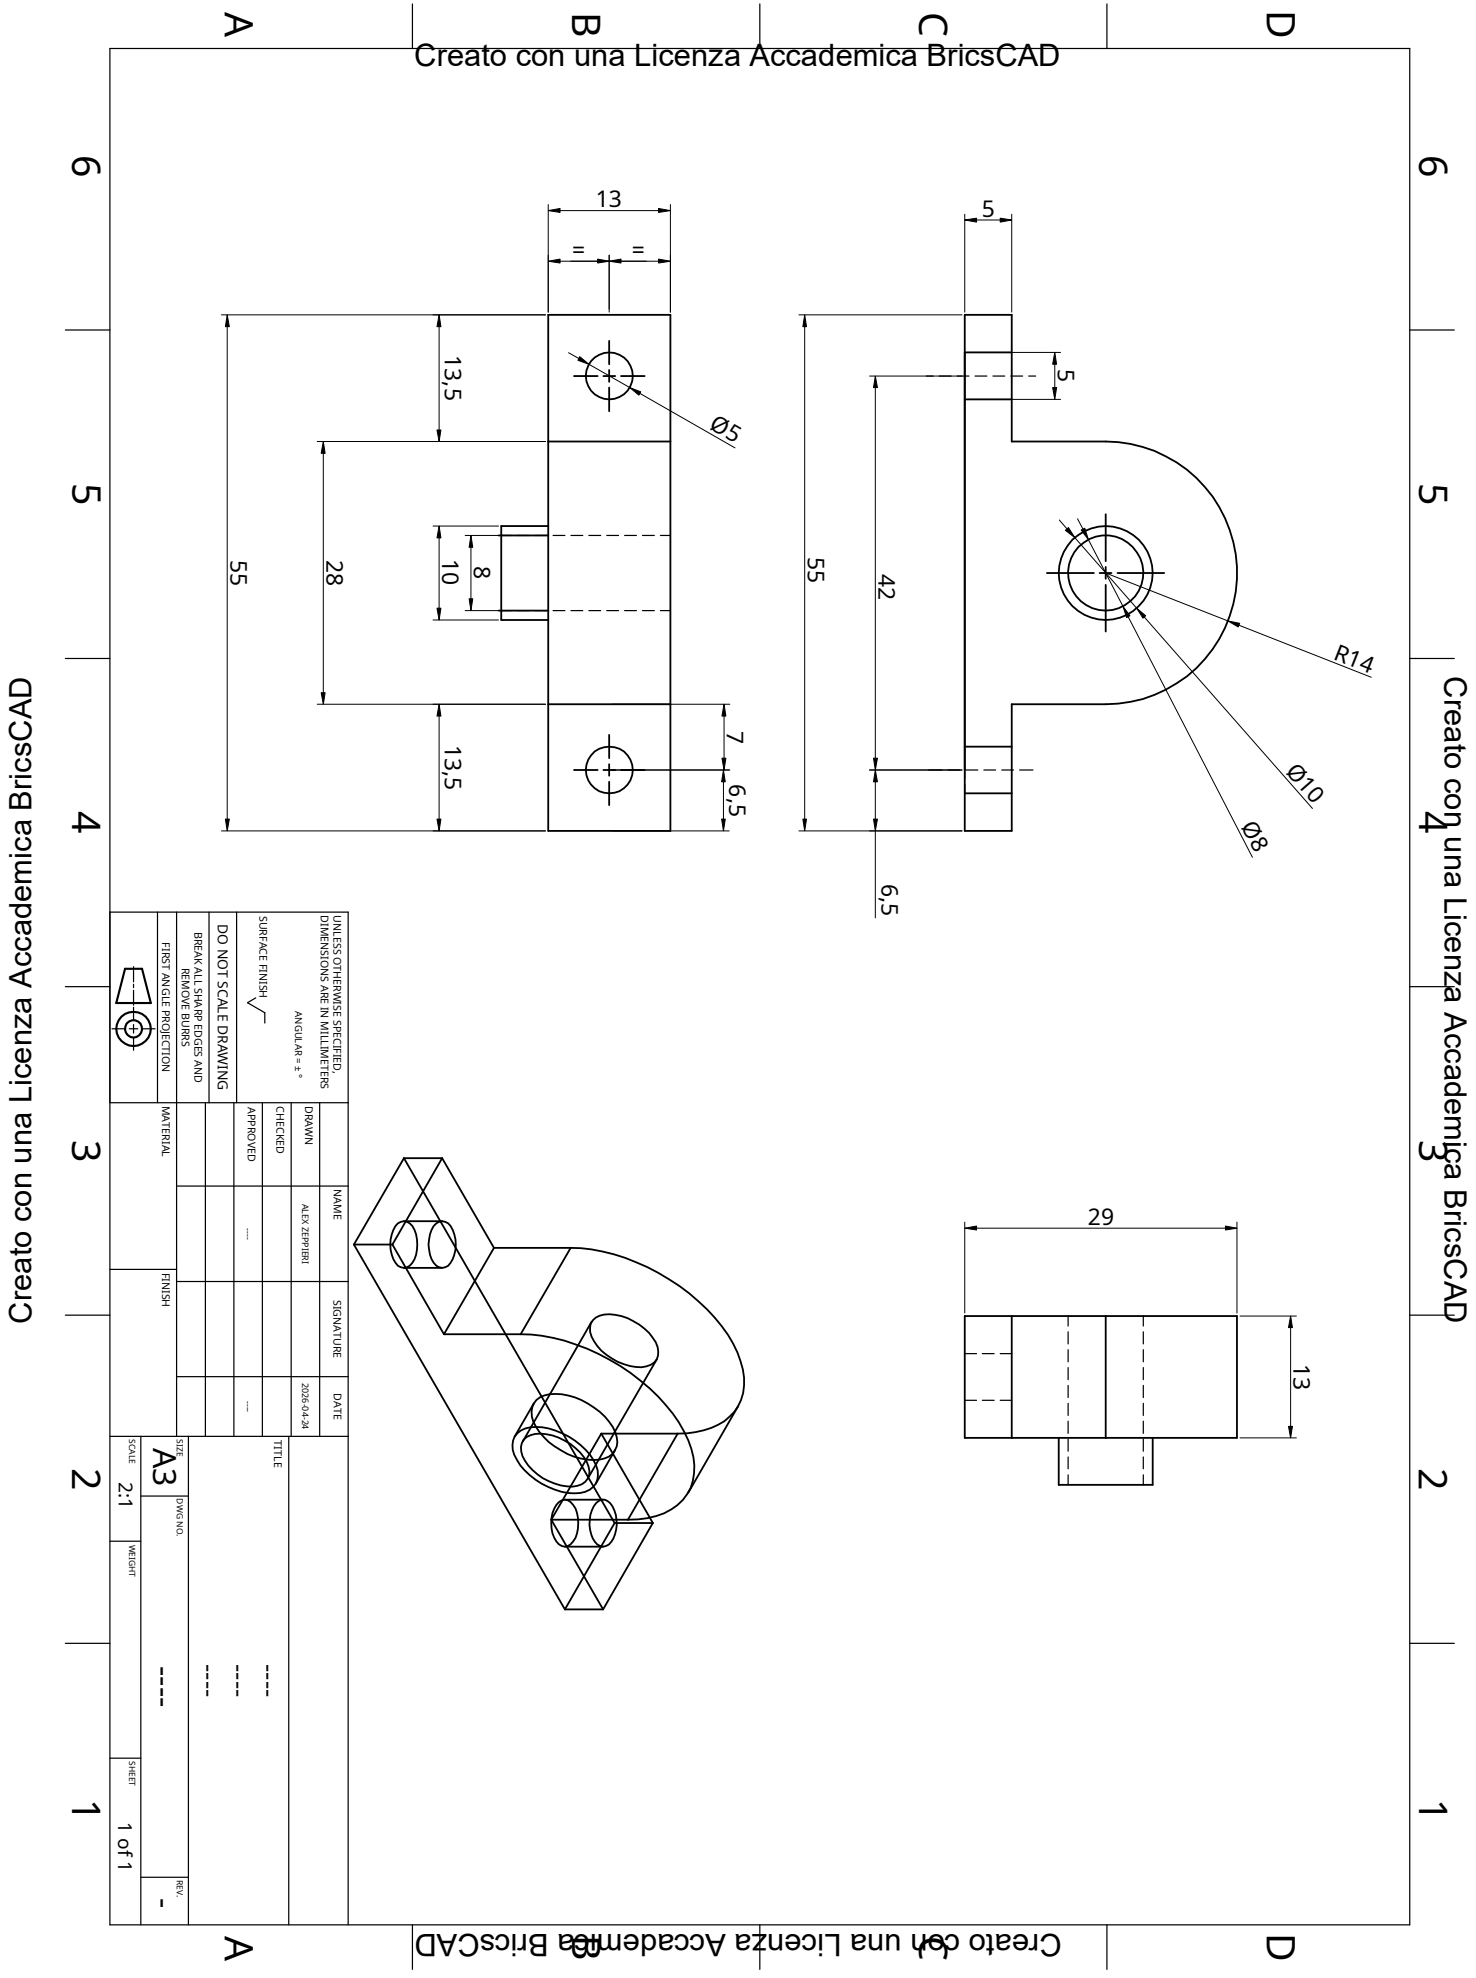
[picture p30: page 1]
Creato con una Licenza Accademica BricsCAD

66 55 44 33 22 11 A A B B C C D D DIMENSIONS ARE IN MILLIMETERS UNLESS OTHERWISE SPECIFIED, ANGULAR = ± ° SURFACE FINISH DO NOT SCALE DRAWING BREAK ALL SHARP EDGES AND REMOVE BURRS FIRST ANGLE PROJECTION SIGNATURE NAME DATE DRAWN ALEX ZEPPIERI 2026-04-24 APPROVED CHECKED ---- ---- MATERIAL FINISH TITLE ---- ---- ---- A3 SIZE DWG NO. ---- REV.- SCALE 2:1 WEIGHT SHEET 1 of 1 55 5 5 Ø10 Ø8 R14
