gilbertocarcano/Progetto-ACME/Docs/Schema elettrico/Schema elettrico (landscape).pdf

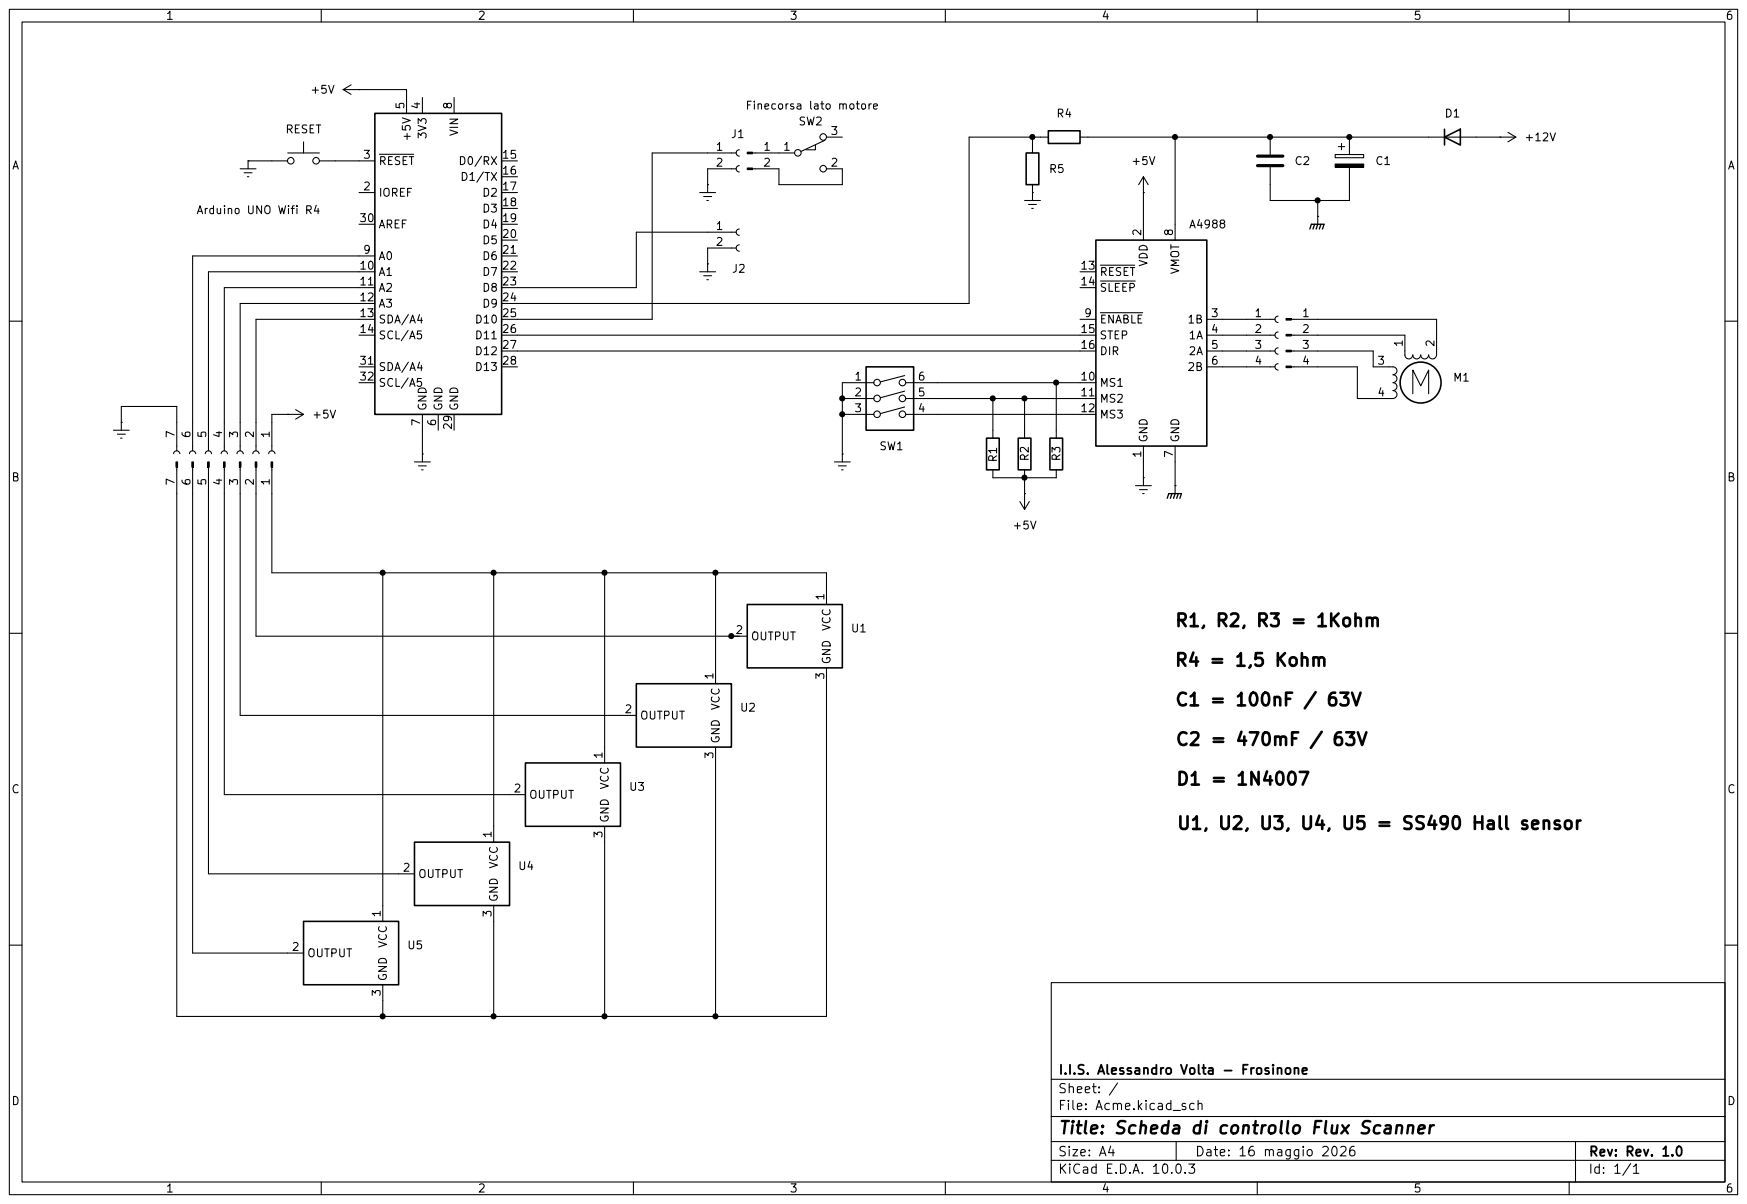
[picture p31: page 1]
