gilbertocarcano/Progetto-ACME/(commit log)

2026-05-06 Initial commit: Firmware + UI
    [ConfigurationClass.h]
2026-05-17 Aggiunto QRCode alla presentazione, eliminato il readme
2026-05-17 esportati file 3D
    [BaseFlangiata.skp, BaseFlangiata.step, EquipaggioMobile.skp, EquipaggioMobile.step, SupportoBobina.skp, SupportoBobina.step, SupportoMotore.skp, SupportoMotore.step]
